mrjacock/hibrew-h10-plus-pressure-control/firmware/README.md

## Safety reminder

Upload firmware only when the espresso machine is unplugged from mains.

Never connect the Arduino USB cable to a computer while the machine is powered from mains.
