mrjacock/hibrew-h10-plus-pressure-control/images/pressure-control-overview.png

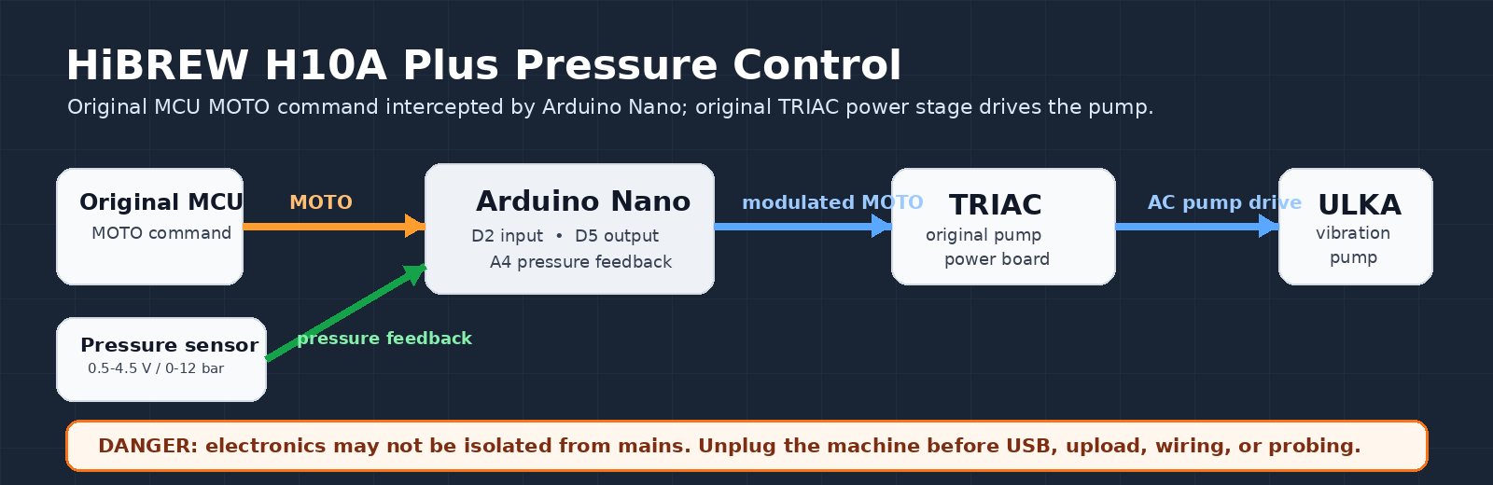
images/pressure-control-overview.png
